YanYunCY/CarRobot/Core/Src/main.c

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
/* Includes ------------------------------------------------------------------*/
#include "main.h"
#include "adc.h"
#include "dma.h"
#include "tim.h"
#include "usart.h"
#include "gpio.h"

/* USER CODE BEGIN Includes */
#include "BSP_USART.h"
#include "math.h"
#include "motor.h"
#include "sensor.h"
#include "edge.h"
#include "system.h"
#include "recover.h"
#include "camera.h"
/* USER CODE END Includes */


void SystemClock_Config(void);
/**
  * @brief  The application entry point.
  * @retval int
  */
int main(void)
{

  /* MCU Configuration--------------------------------------------------------*/

  /* Reset of all peripherals, Initializes the Flash interface and the Systick. */
  HAL_Init();

  /* Configure the system clock */
  SystemClock_Config();

  /* Initialize all configured peripherals */
  MX_GPIO_Init();
  MX_DMA_Init();
  MX_USART1_UART_Init();
  MX_ADC1_Init();
  MX_TIM3_Init();
  MX_TIM8_Init();
  MX_ADC2_Init();
  MX_ADC3_Init();
  MX_USART3_UART_Init();
  /* USER CODE BEGIN 2 */
	printf("Hello world!\r\n");
	HAL_UART_Receive_IT(&huart1, &rx1_buf, 1);
  UART3_Init();

	HAL_TIM_PWM_Start(&htim3,TIM_CHANNEL_1);
  HAL_TIM_PWM_Start(&htim3,TIM_CHANNEL_2);
	
	HAL_TIM_Base_Start_IT(&htim8);
	HAL_ADC_Start_DMA(&hadc1, (uint32_t*)adc_value_adc1, sizeof(adc_value_adc1)/sizeof(adc_value_adc1[0]));
	HAL_ADC_Start_DMA(&hadc2, (uint32_t*)adc_value_adc2, sizeof(adc_value_adc2)/sizeof(adc_value_adc2[0]));
	
	run(stop,0);//初始停止信号，有刷必须要有
	HAL_Delay(2000);
	recover_init();
  /* USER CODE END 2 */

  /* Infinite loop */
  /* USER CODE BEGIN WHILE */
  //uint8_t recover_used = 0;
  while (1)
	{
		system_update();
		// if(!recover_is_active())
    // {
    //     if(recover_detect_off_stage())
    //     {
    //         recover_start();
    //     }
    // }

    // if(recover_is_active())
    // {
    //     recover_update();
    //     continue;   // ❗强烈建议加
    // }
    // if(!recover_used && recover_detect_off_stage())
    // {
    //     recover_blocking();   // 执行一次
    //     recover_used = 1;     // ❗锁死，不再进入
    // }
		//run(go, 10); 
		
		//输出
		printf("IN0: %.2f | IN1: %.2f | IN2: %.2f | IN3: %.2f | IN4: %.2f | IN5: %.2f | IN6: %.2f | IN7: %.2f\r\n",
            get_distance(0),
            get_distance(1),
            get_distance(2),
            get_distance(3),
						get_distance(4),
						get_distance(5),
            get_distance(6),
            get_distance(7));


		//HAL_Delay(10);
  
    /* USER CODE END WHILE */

    /* USER CODE BEGIN 3 */
  }
  /* USER CODE END 3 */
}

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
/* USER CODE BEGIN 4 */
void HAL_TIM_PeriodElapsedCallback(TIM_HandleTypeDef *htim)    //定时器中断回调
{
    HAL_ADC_Start_IT(&hadc1); //定时器中断里面开启ADC中断转换，1ms开启一次采集    
		HAL_ADC_Start_IT(&hadc2);
}

//void HAL_ADC_ConvCpltCallback(ADC_HandleTypeDef* hadc)    //ADC转换完成回调
//{
//    HAL_ADC_Stop_IT(&hadc1);	//关闭ADC
//    HAL_TIM_Base_Stop_IT(&htim4);	//关闭定时器
//    ADC_Value=HAL_ADC_GetValue(&hadc1);	//获取ADC转换的值

//    printf("ADC1 Reading : %d \r\n",ADC_Value);
//    printf("%.4f V\r\n",(ADC_Value*3.3/4096));	 //串口打印电压信息
//    HAL_TIM_Base_Start_IT(&htim4);	//开启定时器
//}


/* USER CODE END 4 */
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
