YanYunCY/CarRobot/STM32F427VGT6.ioc

Mcu.UserName=STM32F427VGTx
PA0/WKUP.Signal=ADCx_IN0
PA1.Signal=ADCx_IN1
PA10.Signal=USART1_RX
PA13.Signal=SYS_JTMS-SWDIO
PA14.Signal=SYS_JTCK-SWCLK
PA2.Signal=ADCx_IN2
PA3.Signal=ADCx_IN3
PA4.Signal=ADCx_IN4
PA5.Signal=ADCx_IN5
PA6.Signal=ADCx_IN6
PA7.Signal=ADCx_IN7
PA8.Signal=RCC_MCO_1
PA9.Signal=USART1_TX
PB8.Signal=I2C1_SCL
PB9.Signal=I2C1_SDA
PC0.Signal=ADCx_IN10
PC1.Signal=ADCx_IN11
PC6.Signal=S_TIM3_CH1
PC7.Signal=S_TIM3_CH2
PD11.Signal=GPIO_Input
PD12.GPIO_Label=Right_Opto
PD12.Signal=GPXTI12
PD13.GPIO_Label=Left_Opto
PD13.Signal=GPXTI13
PD15.Signal=GPIO_Input
PD8.Signal=USART3_TX
PD9.Signal=USART3_RX
PE6.Signal=GPIO_Input
PH0/OSC_IN.Signal=RCC_OSC_IN
PH1/OSC_OUT.Signal=RCC_OSC_OUT
