YanYunCY/CarRobot/Core/Inc/main.h

#define Right_Opto_Pin GPIO_PIN_12
#define Right_Opto_GPIO_Port GPIOD
#define Right_Opto_EXTI_IRQn EXTI15_10_IRQn
#define Left_Opto_Pin GPIO_PIN_13
#define Left_Opto_GPIO_Port GPIOD
#define Left_Opto_EXTI_IRQn EXTI15_10_IRQn
