YanYunCY/CarRobot/Components/BSP/motor.h

#ifndef __MOTOR_H
#define __MOTOR_H

#define stop  10
#define go    11
#define back  12
#define right 13
#define left  14
#define speed 100

void run(int st1,int st2);
void run_diff(int st1,int st2);

#endif
