YanYunCY/CarRobot/Components/BSP/BSP_USART.c

/**
  ****************************(C) COPYRIGHT 2021 Boring_TECH*********************
  * @file       BSP_USART.c/h
  * @brief      将HAL库串口函数进行二次封装，并在串口中断中接收数据
  * @note      	
  * @history
  *  Version    Date            Author          Modification
  *  V3.0.0     2020.7.14     	              	1. done
  *
  @verbatim
  ==============================================================================

  ==============================================================================
  @endverbatim
  ****************************(C) COPYRIGHT 2021 Boring_TECH*********************
  */
#include "BSP_USART.h"


int fputc(int ch, FILE *f)
{
	HAL_UART_Transmit(&huart1, (uint8_t *)&ch, 1, 0xFFFF);
	return ch;
}

int __io_putchar(int ch)
{
	HAL_UART_Transmit(&huart1, (uint8_t *)&ch, 1, 0xFFFF);
	return ch;
}


uint8_t rx1_buf;

/**
	* @brief          串口接收中断回调函数
  * @param[in]     	huart 串口序号
  * @retval         none
  */
void HAL_UART_RxCpltCallback(UART_HandleTypeDef *huart)
{
	
	if(huart->Instance==USART1)
	{
		HAL_UART_Receive_IT(&huart1, &rx1_buf, 1);	
		
		HAL_UART_Transmit(&huart1, &rx1_buf, 1, 100);

	}
	

}
