YanYunCY/CarRobot/(commit log)

2026-04-23 初赛前较稳定的完整代码，加入了多角度上台，和改进apriltag码的避让功能。
2026-04-23 K230摄像头部分代码
2026-04-24 Enhance README with project details and specifications
    Added detailed project documentation for STM32-based combat robot, including hardware specifications, system architecture, and communication protocols.
